blithersoup/midi-5x8/schematic/pcb-back.pdf

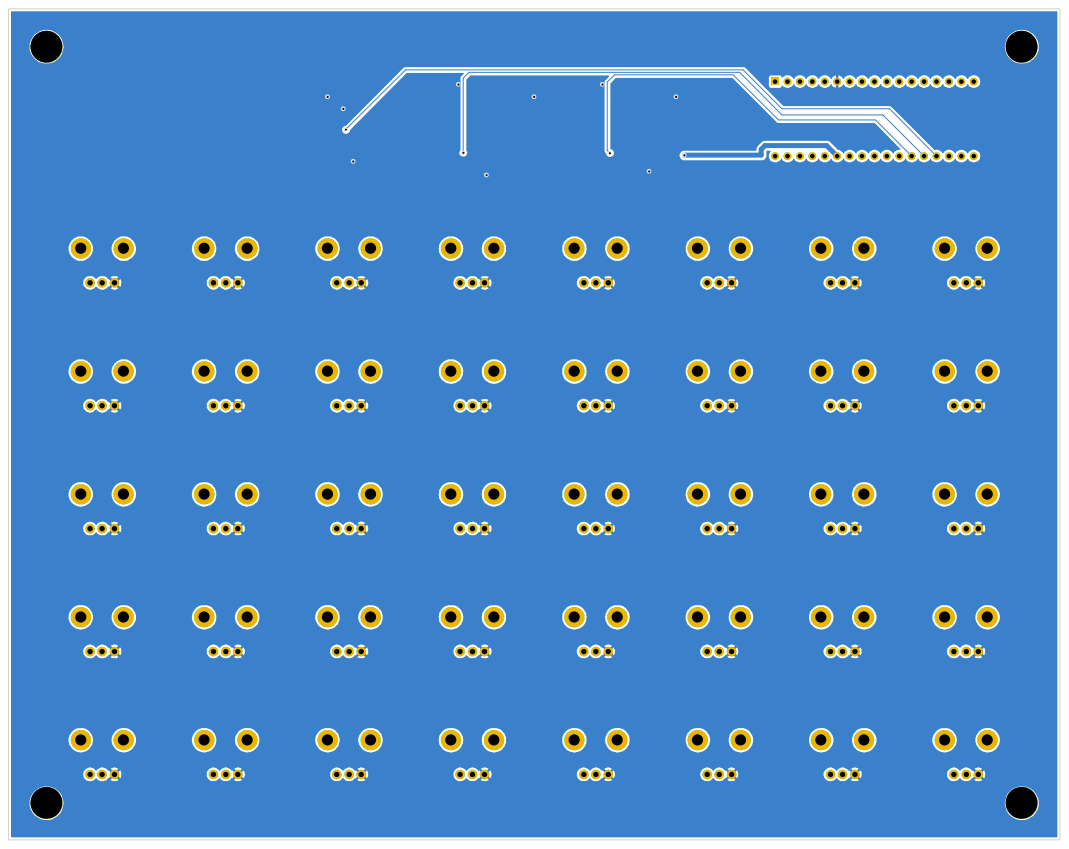
[picture p8: page 1]
