blithersoup/midi-5x8/schematic/pcb-front.pdf

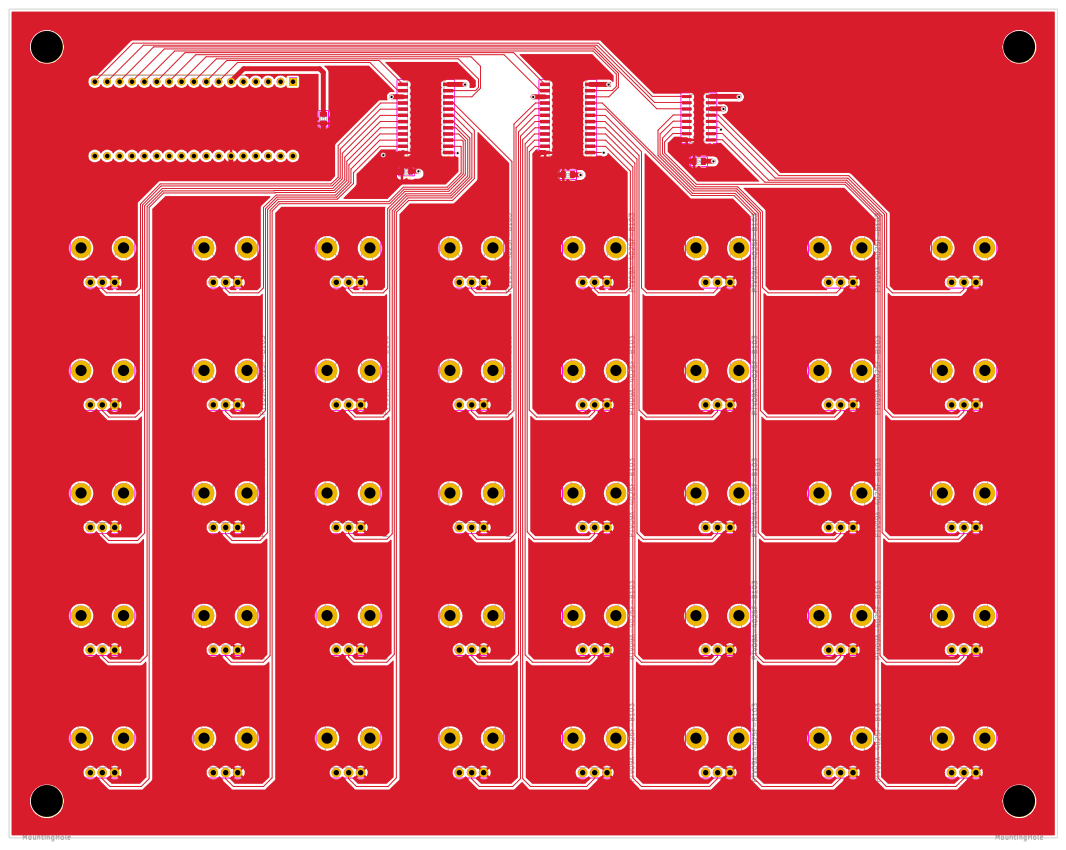
[picture p9: page 1]
