blithersoup/midi-5x8/schematic/schematic.pdf

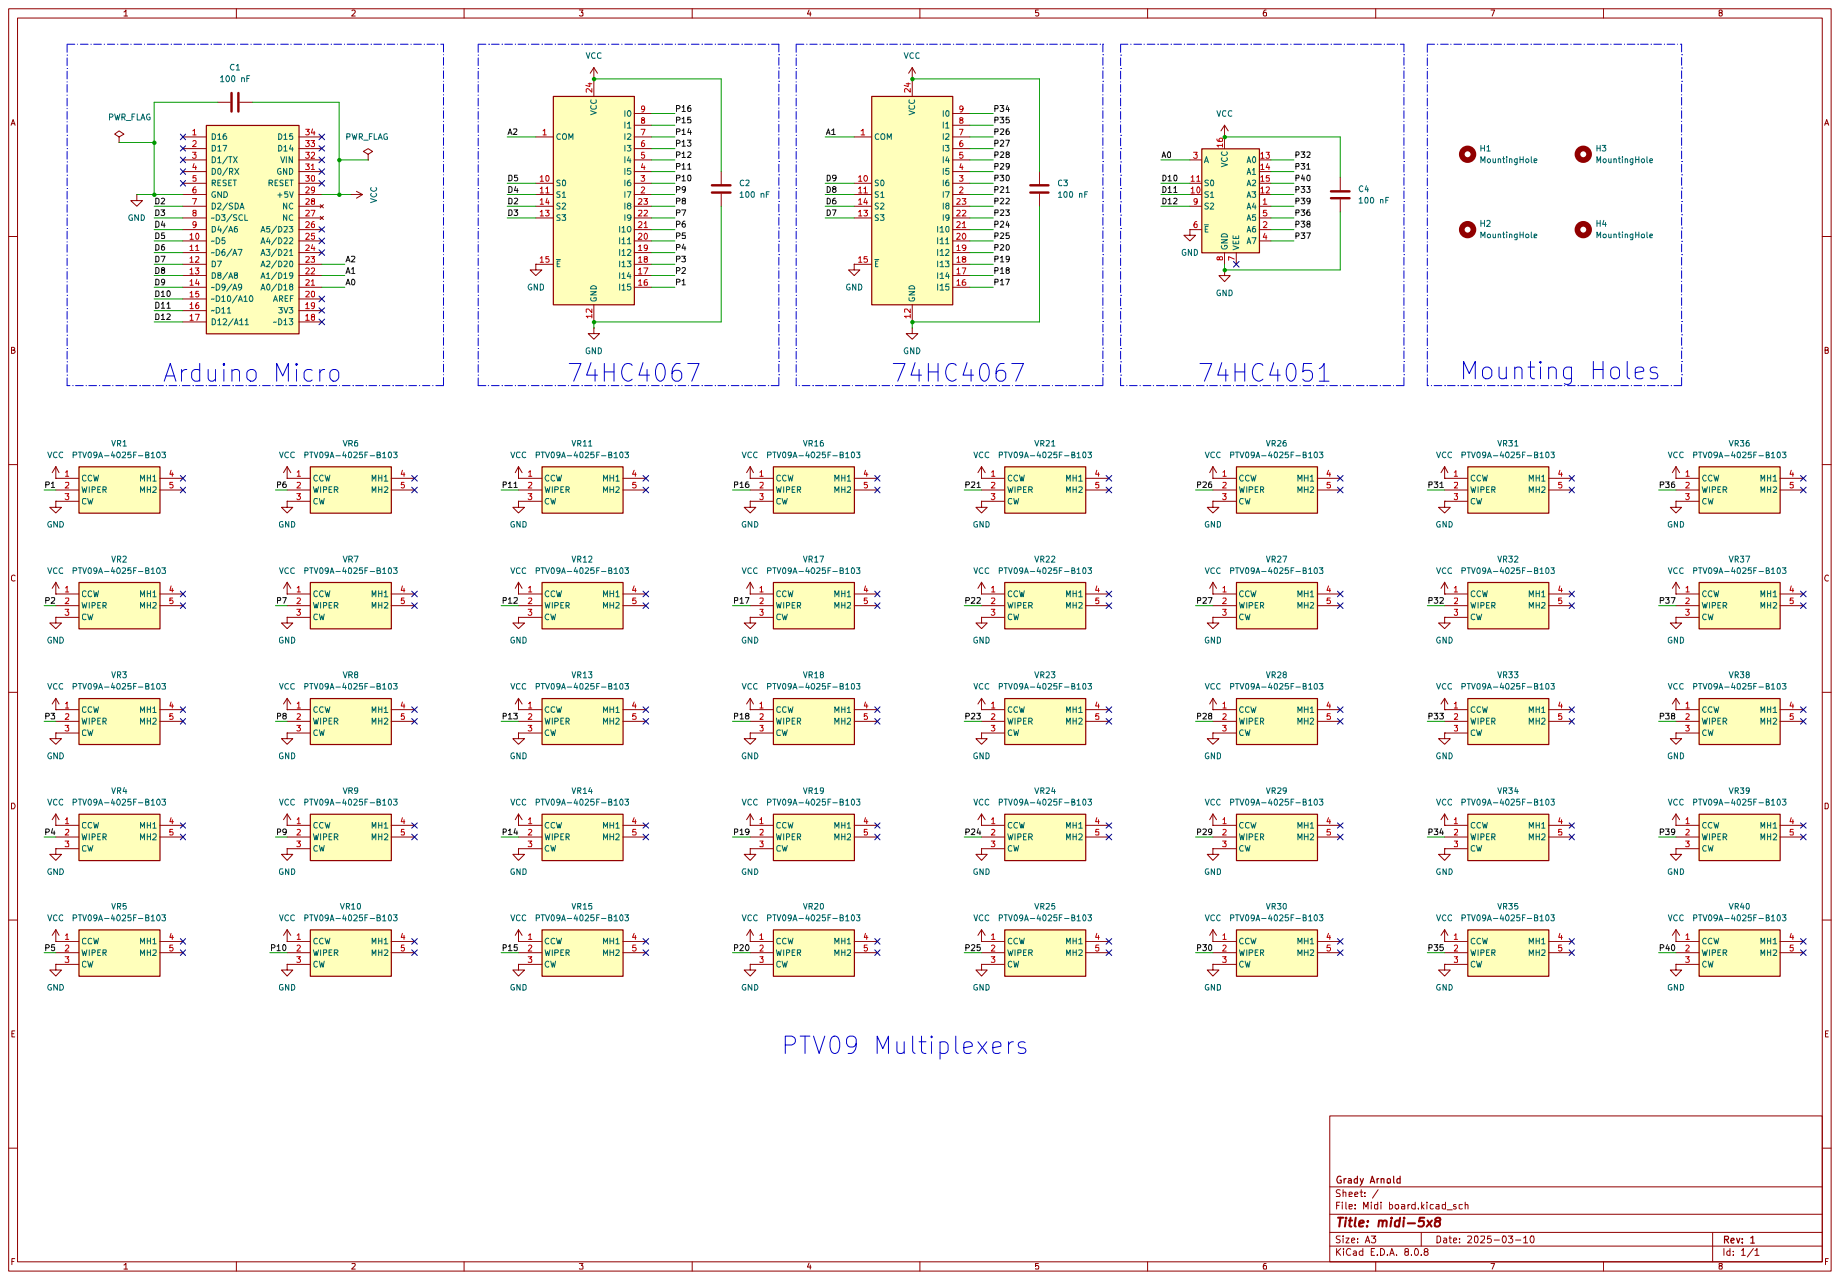
[picture p10: page 1]
